KUBTSSAvionics/Mainboard2026/(commit log)

2025-09-17 Add files via upload
    Raspberry Pi Pico W からESP32に変更 2025.09.17
    [MainBoard2026.kicad_sch]
2025-10-01 Add files via upload
    CANコネクタを増やした
    [MainBoard2026.kicad_sch]
2025-10-03 Add files via upload
    試作前完成版
    [MainBoard2026.kicad_sch]
2025-10-25 Add files via upload
    試作後 抵抗値など修正 2025.10.25
    [MainBoard2026.kicad_sch]
2025-10-25 Add files via upload
    SDカードの書き込みとCANの接続テスト用コード
2025-10-27 GPSの接続テスト
    ジャンパー線を使おう。接続に問題があったときに気づけない。データシートだけでなくライブラリの実装も読もう。データの形式が特殊だった(ソフトウェアの実装はしやすい)。
2025-11-17 Add files via upload
    フットプリント設定完了
    [MainBoard2026.kicad_pcb, MainBoard2026.kicad_sch]
2025-12-25 Add files via upload
    配線完了
    [MainBoard2026.kicad_pcb, MainBoard2026.kicad_sch]
2026-02-10 Add files via upload
    入江さんのフィードバックを回路図に反映
    [MainBoard2026.kicad_sch]
2026-04-28 Add files via upload
    AO3401Aのフットプリントを修正
    [MainBoard2026-B_Cu.gbl, MainBoard2026-B_Mask.gbs, MainBoard2026-B_Paste.gbp, MainBoard2026-B_Silkscreen.gbo, MainBoard2026-Edge_Cuts.gm1, MainBoard2026-F_Cu.gtl, MainBoard2026-F_Mask.gts, MainBoard2026-F_Paste.gtp]
2026-05-27 Add files via upload
    MCP25625のピン19を3V3に変更
    [MainBoard2026-B_Cu.gbl, MainBoard2026-B_Mask.gbs, MainBoard2026-B_Paste.gbp, MainBoard2026-B_Silkscreen.gbo, MainBoard2026-Edge_Cuts.gm1, MainBoard2026-F_Cu.gtl, MainBoard2026-F_Mask.gts, MainBoard2026-F_Paste.gtp]
2026-05-27 Add files via upload
    MCP25625 ピン19を3V3に変更。取付穴を追加。
    [MainBoard2026-B_Cu.gbl, MainBoard2026-B_Mask.gbs, MainBoard2026-B_Paste.gbp, MainBoard2026-B_Silkscreen.gbo, MainBoard2026-Edge_Cuts.gm1, MainBoard2026-F_Cu.gtl, MainBoard2026-F_Mask.gts, MainBoard2026-F_Paste.gtp]
2026-05-27 Add files via upload
    MCP25625を5Vに修正。FXMA2102のピン番号を修正。
    [BME280.step, DFE322512F-100M=P2.STEP, Modular_jack.step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]
